ChristopherKober/Toddler-Alarm-Clock/README.md

# Toddler-Alarm-Clock

This code was written in the Arduino playground and is meant for the Arduino Uno hardware.
Look at the Instructions document for context of the code and how we build the Alarm Clock.

This code uses several libraries:

Adafruit GFX Library: https://github.com/adafruit/Adafruit-GFX-Library
Adafruit SSD1306 Library: https://github.com/adafruit/Adafruit_Python_SSD1306
Adafruit NeoPixel Library: https://github.com/adafruit/Adafruit_NeoPixel
Arduino Time Library: http://playground.arduino.cc/code/time
